physiii/open-dash-daughter/pics/IMG_20180205_184643.jpg

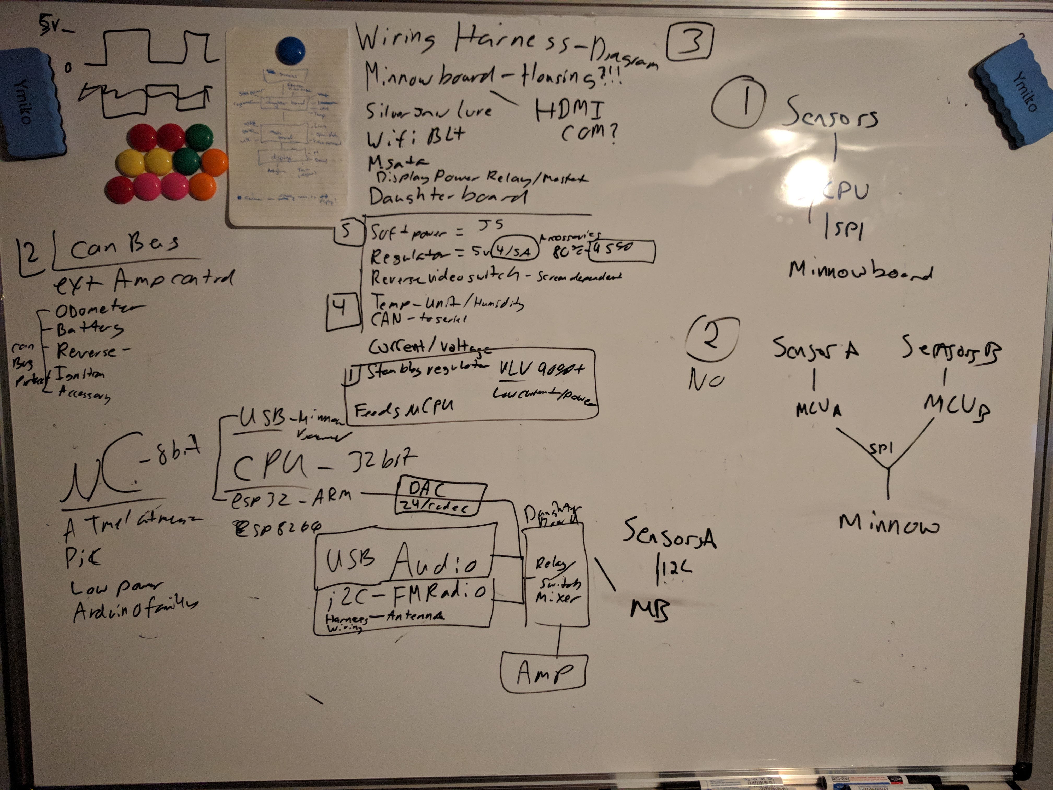
pics/IMG_20180205_184643.jpg
