physiii/open-dash-daughter/documentation/ESP32-MCP2551.jpg

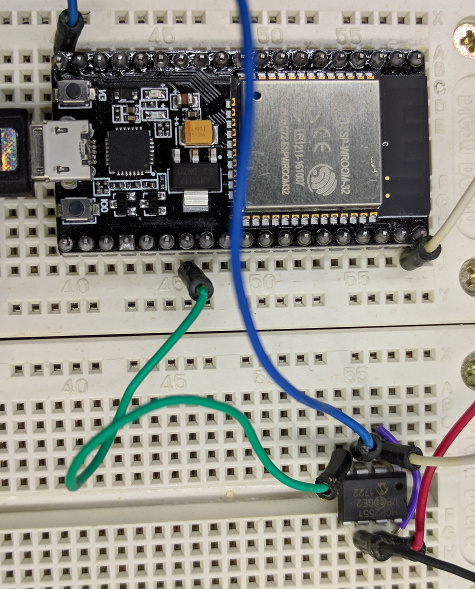
documentation/ESP32-MCP2551.jpg
