physiii/open-dash-daughter/documentation/esp32-dolphin-lights/README.md

let a Dolphin drive the WS2812 LEDs via a serial BT connection to the ESP32

based in part on <https://github.com/FozzTexx/ws2812-demo>
