physiii/open-dash-daughter/documentation/CAN_Static_data.odt

Listing of all IDs that were broadcasting the same data in a ~30 second period without changing, engine was running

Known static conditions:

Outside air temp: 103*F

Odometer: 904 miles

Time/date: 7:01am, Jan 1 2017

Gear: park

ESC mode: on

AC: on

AC fan: on

Speed: 0 mph

6314000: unknown: 0000000000000000

4294001: unknown: 0000B30000000000

421400B: unknown: 00863E0400000000

6214000: Lights, maybe: 0404400000570B00

C054003: unknown: 047005AE815A0000

63D4000: unknown: 9F56000018B70000

4394000: unknown: 00000002

4214006: ESC mode: 0000000000000006

621400A: unknown: 0400

6254000: unknown: 80FFFF00FFFFFF00

6314003: unknown: 0010700000000000

621401A: unknown: 0005010092000000

2214000: unknown: 000000000000

A3D4003: unknown: 2CA51004D0000000

6284000: Steering wheel controls: 0000000000000000

A354003: unknown: 2CA51004D0000000

6314018: Reverse: C000000000000000

62BBF00: unknown: 0000000000000000

A194003: unknown: 0000400000000000

C394003: unknown: C302000008016000

E094000: unknown: 001E05401C4B

E094003: unknown: 001E

E09400A: unknown: 001E

E094018: unknown: 001E

E09401A: unknown: 000E

E094020: unknown: 000A

2294000: unknown: 0000000000000000

C214003: Time/date string: 070101012017

*********************************************************

Another static dump, but with engine off (only one new ID):

4294001: unknown: 0000B30000000000

421400B: unknown: 00863E0400000000

3029100: unknown: 0000000000000000

621401A: unknown: 0005010092000000

4214001: unknown: 0081508B00000000

6214000: Lights, maybe: 0404480000570B00

621400A: unknown: 0400

C054003: unknown: 047005AE895A0000

63D4000: unknown: 9F4F00001AB70000

4394000: unknown: 00000002

4214006: ESC mode: 0000000000000000

6254000: unknown: 00FFFF00FFFFFF00

6314003: unknown: 0010700000000000

2214000: unknown: 000000000000

A3D4003: unknown: 2CA5100500000000

6284000: Steering wheel controls: 0000000000000000

A354003: unknown: 2CA5100500000000

62BBF00: unknown: 0000000000000000

A194003: unknown: 0000400000000000

C394003: unknown: C302000008016000

E094000: Key/ignition status probably: 001E05401C4B

E09400A: unknown: 001E

E094003: unknown: 001E

E094018: unknown: 001E

E09401A: unknown: 000E

E094020: unknown: 000A

6314018: Reverse: C000000000000000

2294000: unknown: 0000000000000000

C214003: Time/date string: 070701012017

***********************************************

IDs that change upon pressing brake:

4294001

421400B

2214000

63D4000

4214001 is more or less static with engine off, but does change as brake pedal is pressed. However, it changes constantly when engine is running. Perhaps this is brake booster pressure.
