physiii/open-dash-daughter/documentation/RadioHarness.pdf

# Connector: Amp PA66−GF35 (PBT−GF15)

# > PBT−GF15 < B1

### RETURN (COMMON)

### CAMERA

### CAMERA SIGNAL

### SHIELD

### CAMERA

CAN
HIGH

LOW

CAN

CHASSIS
GROUND

12vDC
UNSWITCHED

# SPEAKERS

# NEG

# POS

RR− | FR− | FL− | RL−

− MIC +

BL

R REF
IN IN

DET
IN

L
IN

# AUX

3 | 4 | 5

13 18

29

1 | 2 | 6 | 7 | 8 | 9 | 10
11 | 12 | 14 | 15 | 16 | 17 | 19 | 20
21 | 22 | 23 | 24 | 25 | 26 | 27 | 28 | 30
31 | 32 | 33 | 34 | 35 | 36 | 37 | 38 | 39 | 40 | 49 | 50 | 51 | 52
45 | 46 | 47 | 48
41 | 42 | 43 | 44

RADIO ON
(NC)

+
(NC)

NOT CONNECTED ON 2018+ MODELS. LATE MODELS USE CANBUS MESSAGES TO SEND IGNITION/KEY STATUS
