physiii/open-dash-daughter/documentation/CameraHarnessRadio_C.png

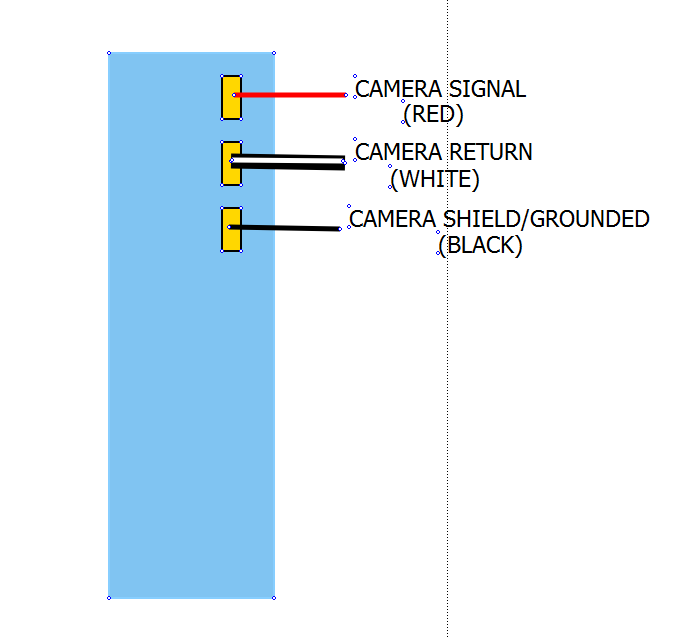
documentation/CameraHarnessRadio_C.png
