physiii/open-dash-daughter/documentation/Stereo wiring.ods

Pin # | Cable Color | Name/Function | Possible function/notes
1 | n/c
2 | Blue/Black | Can +
3 | n/c
4 | n/c
5 | n/c
6 | Green | Aux R | confirmed
7 | Black | Aux Ref
8 | n/c
9 | n/c
10 | n/c
11 | n/c
12 | White/Purple | Can -
13 | Yellow | BL | 12V Battery/Memory
14 | n/c
15 | n/c
16 | White | Aux L | confirmed
17 | Red | Aux DET | 12V Accessory
18 | Black | Ground? | Ground
19 | n/c
20 | n/c
21 | n/c
22 | n/c
23 | n/c
24 | n/c
25 | n/c
26 | n/c
27 | n/c
28 | n/c
29 | Black | Mic -
30 | White | Mic +
31 | Red | Camera Signal
32 | Ground/bare cable | Camera Shield/Ground
33 | Black | Camera Return
34 | n/c
35 | n/c
37 | n/c
37 | n/c
38 | n/c
39 | n/c
40 | n/c
41 | n/c | Radio ON
42 | n/c | 15s +
43 | Black | Ground
44 | Red/Yellow | 30 (+)
45 | Green | Right Rear Speaker (+)
46 | purple/red | Right Front Speaker (+)
47 | Yellow | Left Front Speaker (+)
48 | Orange | Left Rear Speaker (+)
49 | Green/Black | Right Rear Speaker ( - )
50 | Purple/Black | Right Front Speaker ( - )
51 | Yellow/Black | Left Front Speaker ( - )
52 | Orange/Black | Left Rear Speaker ( - )
Blue GPS | 2.188 Kohm
White Radio | open circuit no capacitance
