physiii/open-dash-daughter/open-dash-daughterboard.kicad_pcb

## KiCad design open-dash-daughterboard.kicad_pcb (2018-06-05)

Schematic: power.sch

Parts:
C1, C2, C3, C4: 180uF; CP_Radial_D8.0mm_P3.50mm; Part Number EKZN500ELL181MH20D
C5, C6: 1000uF; CP_Radial_D10.0mm_P5.00mm; Part Number 25YXJ1000M10X20
C7, C8: C_1000uF; CP_Radial_D10.0mm_P3.50mm; Part Number UVR0J102MPD1TD
C9, C12: C_4.7uF; C_0603_1608Metric_Pad0.99x1.00mm_HandSolder; Part Number CL10B475KQ8NQNC
D1: 26V Zener; D_SMB; Part Number SMBJ26CATR
D2, D3, D4, D5: D_Schottky; D_SMA; Part Number CDBA540-HF
D6: LED-0603-G; LED_0603_1608Metric_Pad0.82x1.00mm_HandSolder; Part Number SML-D12M8WT86
L1: L_47uH; Inductor-SRR1210; Part Number SRR1210-470M
L2, L3, L4: L_100uH; Inductor-SRR1210; Part Number SRR1210-101M
R1, R2, R3: R_10k; R_0603_1608Metric_Pad0.99x1.00mm_HandSolder; Part Number RC0603JR-0710KL
R4, R10: R_7k15; R_0603_1608Metric_Pad0.99x1.00mm_HandSolder; Part Number CRCW06037K15FKEA
R5: R_2k32; R_0603_1608Metric_Pad0.99x1.00mm_HandSolder; Part Number RC0603FR-072K32L
R6, R8: R_8k87; R_0603_1608Metric_Pad0.99x1.00mm_HandSolder; Part Number RC0603JR-0710KL
R7, R9: R_1k; R_0603_1608Metric_Pad0.99x1.00mm_HandSolder; Part Number RC0603JR-071KL
R11: R_1k3; R_0603_1608Metric_Pad0.99x1.00mm_HandSolder; Part Number RC0603FR-071K3L
R12: R_1k4; R_0603_1608Metric_Pad0.99x1.00mm_HandSolder; Part Number RC0603FR-071K4L
U1, U2, U3, U4: LM2576-ADJ; Regulator-LM2576; Part Number LM2576SX-ADJ/NOPB
U5: REG-3.3v; TO-252-2; Part Number NCP1117DT33T5G

Connections:
/3v3: C9.1, D6.2, R1.1, R2.1, R3.1, U5.2; also elsewhere on the board
/5V: C5.1, C12.1, L1.2, R4.1, U5.3; also elsewhere on the board
/AUDIO_POWER: C8.1, L2.2, R10.1; also elsewhere on the board
/BATTERY: C1.1, C3.1, C4.1, D1.1, U1.1, U2.1, U4.1; also elsewhere on the board
/DISPLAY_POWER: C7.1, L4.2, R8.1; also elsewhere on the board
/EN_AUDIO: R1.2, U2.5; also elsewhere on the board
/EN_DISPLAY: R3.2, U4.5; also elsewhere on the board
/EN_MAIN: R2.2, U3.5; also elsewhere on the board
/MAIN_POWER: C6.1, L3.2, R6.1; also elsewhere on the board
/V_MAIN: C2.1, U3.1; also elsewhere on the board
AGND: C1.2, C2.2, C3.2, C4.2, C5.2, C6.2, C7.2, C8.2, C9.2, C12.2, D1.2, D2.2, D3.2, D4.2, D5.2, R5.2, R7.2, R9.2, R11.2, R12.2, U1.3, U1.5, U2.3, U3.3, U4.3, U5.1; also elsewhere on the board
unnamed: D2.1, L1.1, U1.2
unnamed: D3.1, L2.1, U2.2
unnamed: D4.1, L3.1, U3.2
unnamed: D5.1, L4.1, U4.2
unnamed: D6.1, R12.1
unnamed: R4.2, R5.1, U1.4
unnamed: R6.2, R7.1, U3.4
unnamed: R8.2, R9.1, U4.4
unnamed: R10.2, R11.1, U2.4

Notes on the sheet:
V_MAIN is after the current sense resistor.
12V Battery Protection
output voltage = 1.23 (1 + R2/R1) R2 is on high side

Schematic: microcontroller.sch

Parts:
C10: C_10uF; C_0603_1608Metric_Pad0.99x1.00mm_HandSolder; Part Number GRM188R61A106ME69D
C11: C_1uF; C_0603_1608Metric_Pad0.99x1.00mm_HandSolder; Part Number CC0603ZRY5V7BB105
R13, R14, R15: R_10k; R_0603_1608Metric_Pad0.99x1.00mm_HandSolder; Part Number RC0603JR-0710KL
U6: ESP-WROOM-32

Connections:
/3v3: C10.1, C11.1, R13.2, R14.2, U6.2; also elsewhere on the board
/CAN_RX: U6.26; also elsewhere on the board
/CAN_TX: U6.29; also elsewhere on the board
/EN_AUDIO: U6.27; also elsewhere on the board
/EN_DISPLAY: U6.23; also elsewhere on the board
/EN_ESP: U6.3; also elsewhere on the board
/EN_MAIN: U6.30; also elsewhere on the board
/FACTORY: U6.13; also elsewhere on the board
/MUTE_AUDIO: U6.9; also elsewhere on the board
/PROG: U6.25; also elsewhere on the board
/RXD: U6.34; also elsewhere on the board
/SCL: R14.1, U6.33; also elsewhere on the board
/SDA: R13.1, U6.31; also elsewhere on the board
/SOFT_POWER: U6.14; also elsewhere on the board
/STBY_AUDIO: U6.8; also elsewhere on the board
/TXD: U6.35; also elsewhere on the board
AGND: C10.2, C11.2, R15.1, U6.1; also elsewhere on the board
unnamed: R15.2, U6.24

Notes on the sheet:
Bypass CAPs

Schematic: canbus.sch

Parts:
C15: 0.1uF; C_0603_1608Metric_Pad0.99x1.00mm_HandSolder; Part Number C0603C104K5RACTU
C16, C17: 560pF; C_0603_1608Metric_Pad0.99x1.00mm_HandSolder; Part Number CL10B561KB8NNNC
D7: PESD1CAN; SOT-323_SC-70_Handsoldering; Part Number PESD1CAN-UX
R18: 4.7k; R_0603_1608Metric_Pad0.99x1.00mm_HandSolder; Part Number RC0603JR-074K7L
R19, R20: 100; R_0603_1608Metric_Pad0.99x1.00mm_HandSolder; Part Number RC0603JR-07100RL
U8: MCP2551-I_SN; SOIC-8_3.9x4.9mm_P1.27mm; Part Number MCP2551-I/SN

Connections:
/5V: C15.1, U8.3; also elsewhere on the board
/CAN+: D7.2, R20.1, U8.7; also elsewhere on the board
/CAN-: D7.1, R19.1, U8.6; also elsewhere on the board
/CAN_RX: U8.4; also elsewhere on the board
/CAN_TX: U8.1; also elsewhere on the board
AGND: C15.2, C16.2, C17.2, D7.3, R18.2, U8.2; also elsewhere on the board
unnamed: C16.1, R19.2
unnamed: C17.1, R20.2
unnamed: R18.1, U8.8

Schematic: environment.sch

Parts:
C18, C19: C_0.1uF; C_0603_1608Metric_Pad0.99x1.00mm_HandSolder; Part Number C0603C104K5RACTU
R21: R_10; R_2512_6332Metric_Pad1.49x3.40mm_HandSolder; Part Number CPF0603B10RE
U9: SI7020-A20; Part Number SI7020-A20-GM1R
U10: Power-Monitor-INA219; SOT-23-8_Handsoldering; Part Number INA219AIDCNR

Connections:
/3v3: C18.1, C19.2, U9.5, U10.4, U10.7; also elsewhere on the board
/BATTERY: R21.1, U10.1; also elsewhere on the board
/SCL: U9.6, U10.5; also elsewhere on the board
/SDA: U9.1, U10.6; also elsewhere on the board
/V_MAIN: R21.2, U10.2; also elsewhere on the board
AGND: C18.2, C19.1, U9.2, U10.3, U10.8; also elsewhere on the board

Schematic: audio-amplifier.sch

Parts:
C20, C21: 0.22uF; C_0603_1608Metric_Pad0.99x1.00mm_HandSolder; Part Number CL10B224KO8NNNC
C22: 470uF; CP_Radial_D8.0mm_P3.50mm; Part Number 16YXJ470M8X11.5
C23, C48, C49: C_1uF; C_0603_1608Metric_Pad0.99x1.00mm_HandSolder; Part Number CC0603ZRY5V7BB105
C24, C44, C45, C51, C52: C_10uF; C_0603_1608Metric_Pad0.99x1.00mm_HandSolder; Part Number GRM188R61A106ME69D
C25: 100nF; C_0603_1608Metric_Pad0.99x1.00mm_HandSolder; Part Number CL10B104KA8NFNC
C47, C53: C_100p; C_0603_1608Metric_Pad0.99x1.00mm_HandSolder; Part Number C0603C101J3GACTU
C50: C_0.1uF; C_0603_1608Metric_Pad0.99x1.00mm_HandSolder; Part Number C0603C104K5RACTU
P1: CONN_01X04; PinHeader_1x04_P2.54mm_Vertical
P2: CONN_01X02; PinHeader_1x02_P2.54mm_Vertical
R22, R23: R_10k; R_0603_1608Metric_Pad0.99x1.00mm_HandSolder; Part Number RC0603JR-0710KL
R43, R44, R45, R46, R47, R48, R49, R50: R_20k; R_0603_1608Metric_Pad0.99x1.00mm_HandSolder; Part Number RC0603JR-0720KL
U11: TDA7297; TO-220-15_Vertical_StaggeredType1_Py5.08mm; Part Number TDA7297
U19: OPA1662; MSOP-8_3x3mm_P0.65mm; Part Number OPA1662AIDGKR

Connections:
/AUDIO_POWER: C22.2, C25.1, C49.1, C50.1, U11.3, U11.13, U19.8; also elsewhere on the board
/FL_AUDIO_OUT+: U11.1; also elsewhere on the board
/FL_AUDIO_OUT-: U11.2; also elsewhere on the board
/FR_AUDIO_OUT+: U11.15; also elsewhere on the board
/FR_AUDIO_OUT-: U11.14; also elsewhere on the board
/L_FM_AUDIO: C44.2, P1.1; also elsewhere on the board
/L_MAIN_AUDIO: C45.2, P1.3; also elsewhere on the board
/MUTE_AUDIO: R22.2; also elsewhere on the board
/R_FM_AUDIO: C51.1, P1.2; also elsewhere on the board
/R_MAIN_AUDIO: C52.1, P1.4; also elsewhere on the board
/STBY_AUDIO: R23.2; also elsewhere on the board
/audio amplifier/L_AUDIO_IN: C47.1, P2.1, R45.1, R50.2, U19.1
/audio amplifier/R_AUDIO_IN: C53.1, P2.2, R48.2, R49.2, U19.7
AGND: C22.1, C23.2, C24.2, C25.2, C48.2, C49.2, C50.2, U11.8, U11.9, U19.4; also elsewhere on the board
unnamed: C20.1, U11.4
unnamed: C20.2, R49.1
unnamed: C21.1, U11.12
unnamed: C21.2, R50.1
unnamed: C23.1, R22.1, U11.6
unnamed: C24.1, R23.1, U11.7
unnamed: C44.1, R43.2
unnamed: C45.1, R44.2
unnamed: C47.2, R43.1, R44.1, R45.2, U19.2
unnamed: C48.1, U19.3, U19.5
unnamed: C51.2, R46.1
unnamed: C52.2, R47.1
unnamed: C53.2, R46.2, R47.2, R48.1, U19.6

Schematic: FM-radio.sch

Parts:
C26: 3.9pF; C_0603_1608Metric_Pad0.99x1.00mm_HandSolder; Part Number CL10C3R9CB8NNNC
C27: 18pF; C_0603_1608Metric_Pad0.99x1.00mm_HandSolder; Part Number VJ0603A180JXACW1BC
C28, C39, C41: 0.1uF; C_0603_1608Metric_Pad0.99x1.00mm_HandSolder; Part Number C0603C104K5RACTU
C29: 270pF; C_0603_1608Metric_Pad0.99x1.00mm_HandSolder; Part Number C0603C271JAGAC7867
C30: 1200pF; C_0603_1608Metric_Pad0.99x1.00mm_HandSolder; Part Number CL10B122KB8NNNC
C31, C33, C34: 0.47uF; C_0603_1608Metric_Pad0.99x1.00mm_HandSolder; Part Number CC0603ZRY5V7BB474
C32: 100uF; C_0603_1608Metric_Pad0.99x1.00mm_HandSolder; Part Number ESK107M010AC3AA
C35: 18nF; C_0603_1608Metric_Pad0.99x1.00mm_HandSolder; Part Number CL10B183JB8NNNC
C36, C40: 22nF; C_0603_1608Metric_Pad0.99x1.00mm_HandSolder; Part Number CL10B223KA8NNWC
C37, C38: 0.39uF; C_0603_1608Metric_Pad0.99x1.00mm_HandSolder; Part Number GRM188R71C394KA88D
D8, D9: D1213A-01SO-7; SOT-23; Part Number D1213A-01SO-7
L5, L6: 6.8uH; Coilcraft_0805PS_Handsoldering; Part number 0805PS-682KLB
L7: 33nH; L_0603_HandSoldering; Part Number CW160808-33NJ
L8: 122nH; L_0603_HandSoldering; Part Number PE-0603CD121GTT
L9: 220uH; Coilcraft_1008PS_Handsoldering; Part Number 1008PS-224KLB
L10: 1mH; L_7.3x7.3_H4.5; Part Number SRR0745A-102M
L11: 33uH; L_6.3x6.3_H3; Part Number SRR0604-330KL
Q1: Q_NPN_BEC; SOT-23; Part Number KST10MTF
Q2, Q3: Q_NJFET_DGS; SOT-23; Part Number BF861C,215
R24: 4.7k; R_0603_1608Metric_Pad0.99x1.00mm_HandSolder; Part Number RC0603JR-074K7L
R25, R27, R28: 249; R_0603_1608Metric_Pad0.99x1.00mm_HandSolder; Part Number RC0603FR-07249RL
R26: 10M; R_0603_1608Metric_Pad0.99x1.00mm_HandSolder; Part Number RC0603JR-0710ML
R29: 10; R_0603_1608Metric_Pad0.99x1.00mm_HandSolder; Part Number RC0603FR-0710RL
R30, R31, R32: 2k; R_0603_1608Metric_Pad0.99x1.00mm_HandSolder; Part Number RC0603JR-072KL
U12: Si4740; QFN-24-1EP_4x4mm_Pitch0.5mm; Part Number TDA7297
U18: 74LVC1G17SE-7; SOT-353_SC-70-5_Handsoldering; Part Number 74LVC1G17SE-7

Connections:
/3v3: C28.2, C36.2, C39.2, C40.2, C41.2, R24.1, R27.1, R29.2, U12.12, U12.13, U18.5; also elsewhere on the board
/AMF_Antenna: C27.2, L5.1; also elsewhere on the board
/FM Radio/FM_INT: U12.20
/FM Radio/FM_RADIO_RST: R30.2
/FM Radio/am_passive_ant_en: R24.2, U12.21, U18.2
/L_FM_AUDIO: C38.1; also elsewhere on the board
/R_FM_AUDIO: C37.1; also elsewhere on the board
/SCL: R31.2; also elsewhere on the board
/SDA: R32.2; also elsewhere on the board
AGND: C26.2, C28.1, C31.1, C32.2, C33.2, C36.1, C39.1, C40.1, C41.1, D8.2, D8.3, D9.2, D9.3, L8.2, L10.2, Q1.2, R26.2, R28.2, U12.2, U12.5, U12.8, U12.14, U18.3; also elsewhere on the board
unnamed: C26.1, L5.2, L6.1
unnamed: C27.1, L7.1
unnamed: C29.1, C30.2, D9.1, Q3.3, R26.1
unnamed: C29.2, L6.2
unnamed: C30.1, Q1.3
unnamed: C31.2, Q2.3
unnamed: C32.1, C33.1, L9.1, R29.1
unnamed: C34.1, L9.2, Q2.1
unnamed: C34.2, U12.6
unnamed: C35.1, L11.2
unnamed: C35.2, L10.1, Q3.2
unnamed: C37.2, U12.15
unnamed: C38.2, U12.16
unnamed: D8.1, L7.2, L8.1, U12.1
unnamed: L11.1, U12.3
unnamed: Q1.1, R25.1
unnamed: Q2.2, Q3.1
unnamed: R25.2, U18.4
unnamed: R27.2, R28.1
unnamed: R30.1, U12.7
unnamed: R31.1, U12.9
unnamed: R32.1, U12.10

Notes on the sheet:
22pF Whip antenna
FM Intrusion FIlter
i2c add: 0010001x
TODO: 32.768kHZ oscillaotr if needed?

Schematic: GPS-interface.sch

Parts:
C42: C_1uF; C_0603; Part Number CC0603ZRY5V7BB105
C43: C_0.1uF; C_0603; Part Number C0603C104K5RACTU
R33, R34, R35, R36, R42: R_10k; R_0603_1608Metric_Pad0.99x1.00mm_HandSolder; Part Number RC0603JR-0710KL
RX_TX1: CONN_01X02; PinHeader_1x02_P2.54mm_Vertical
U13: A2235-H; GSM_Module_17.8x16.5mm_A2235-H; MPN A2235-H; Digi-Key_PN 1530-1011-1-ND

Connections:
/GPS interface/3v3: C42.1, C43.1, R35.1, U13.3 (VCC3V3), U13.11 (VANT)
/GPS interface/ANT_SW: R33.1, U13.12 (ANT_SW)
/GPS interface/EN_I2C: R34.2, U13.8 (GPIO7)
/GPS interface/RST_GPS: R35.2, U13.1 (nRST)
/GPS interface/Vout: R42.1, U13.5 (VOUT)
/GPS interface/WAKEUP: U13.4 (WAKEUP), U13.19 (ON_OFF)
/GPS_Antenna: U13.10 (ANT_EXT); also elsewhere on the board
/SCL: U13.17 (GPIO1); also elsewhere on the board
/SDA: U13.18 (GPIO0); also elsewhere on the board
AGND: C42.2, C43.2, R33.2, R34.1, R36.1, U13.6 (GND), U13.9 (GND), U13.23 (GND); also elsewhere on the board
unnamed: R36.2, U13.20 (EXTINT)
unnamed: R42.2, U13.7 (GPIO6)
unnamed: RX_TX1.1, U13.21 (TXO/SPI)
unnamed: RX_TX1.2, U13.22 (RXO/SPI_DI)

Schematic: interface.sch

Parts:
AMF_Antenna1: Conn_01x02; PinHeader_1x02_P2.54mm_Vertical
AUDIO_IN1: Conn_01x02; PinHeader_1x03_P2.54mm_Vertical
D10, D11, D12: LED; LED_0603_1608Metric_Pad0.82x1.00mm_HandSolder; Part Number 475-2512-2-ND
FACTORY1: SW_PUSH; SW_SPST_KMR2; Part Number KMR211NG LFS
GPS_ANT1: Conn_01x02; PinHeader_1x02_P2.54mm_Vertical
J4: Conn_02x06_Odd_Even; PinHeader_2x06_P2.54mm_Vertical
PROG1: SW_PUSH; SW_SPST_KMR2; Part Number KMR211NG LFS
R16, R17, R38, R39: R_10k; R_0603_1608Metric_Pad0.99x1.00mm_HandSolder; Part Number RC0603JR-0710KL
REBOOT1: SW_PUSH; SW_SPST_KMR2; Part Number KMR211NG LFS
U7, U14, U16: molex-2x4-5.7mm; Part Number 0768290008
U15: radio-housing-mounts

Connections:
/3v3: D10.2 (A), D11.2 (A), D12.2 (A), J4.3, R16.1; also elsewhere on the board
/5V: J4.4, U16.3; also elsewhere on the board
/AMF_Antenna: AMF_Antenna1.1; also elsewhere on the board
/BATTERY: U7.1; also elsewhere on the board
/CAN+: U7.4; also elsewhere on the board
/CAN-: U7.5; also elsewhere on the board
/DISPLAY_POWER: U16.2; also elsewhere on the board
/EN_ESP: R38.2, REBOOT1.1; also elsewhere on the board
/FACTORY: FACTORY1.1, J4.7, R17.2; also elsewhere on the board
/FL_AUDIO_OUT+: U14.1, U14.3; also elsewhere on the board
/FL_AUDIO_OUT-: U14.5, U14.6; also elsewhere on the board
/FR_AUDIO_OUT+: U14.2, U14.4; also elsewhere on the board
/FR_AUDIO_OUT-: U14.7, U14.8; also elsewhere on the board
/GPS_Antenna: GPS_ANT1.1; also elsewhere on the board
/L_MAIN_AUDIO: AUDIO_IN1.2; also elsewhere on the board
/MAIN_POWER: U16.1; also elsewhere on the board
/PROG: J4.5, PROG1.1, R39.2; also elsewhere on the board
/RXD: J4.6; also elsewhere on the board
/R_MAIN_AUDIO: AUDIO_IN1.3; also elsewhere on the board
/SCL: J4.10; also elsewhere on the board
/SDA: J4.9; also elsewhere on the board
/SOFT_POWER: J4.11, R16.2, U7.2, U16.4; also elsewhere on the board
/TXD: J4.8; also elsewhere on the board
/interface/CAMERA+: U7.3
/interface/CAMERA-: U7.6
/interface/CAMERA_S: U7.7
AGND: AMF_Antenna1.2, AUDIO_IN1.1, FACTORY1.2, GPS_ANT1.2, J4.1, J4.2, PROG1.2, REBOOT1.2, U7.8, U16.6, U16.7, U16.8; also elsewhere on the board
unnamed: D10.1 (K), R17.1
unnamed: D11.1 (K), R38.1
unnamed: D12.1 (K), R39.1

Notes on the sheet:
AM/FM Antenna
GPS Antenna

Schematic: usb-interface.sch

Parts:
C13: C_10uF; C_0603; Part Number GRM188R61A106ME69D
C14: C_0.1uF; C_0603; Part Number C0603C104K5RACTU
C46: C_1uF; C_0603; Part Number CC0603ZRY5V7BB105
P4: CONN_01X04; PinHeader_2x04_P2.54mm_Vertical; Part Number 0887388000
Q4: Q_NPN_BCE; SOT-23; Part Number MMSS8050-H-TP
Q5: Q_PNP_BCE; SOT-23; Part Number MMSS8550-L-TP
R37: R_470; R_0603; Part Number RC0603FR-07470RL
R40, R41: R_12k; R_0603_1608Metric_Pad0.99x1.00mm_HandSolder; Part Number RC0603JR-0712KL
U17: USB_IC-CP2104; QFN-24-1EP_3x3mm_Pitch0.4mm; Part Number CP2102N-A01-GQFN20

Connections:
/5V: C13.1, C14.1, P4.1, U17.7, U17.8; also elsewhere on the board
/EN_ESP: Q4.2; also elsewhere on the board
/PROG: Q5.2; also elsewhere on the board
/RXD: R37.1; also elsewhere on the board
/TXD: U17.20; also elsewhere on the board
/USB interface/DCD: P4.2, U17.24
/USB interface/DSR: P4.6, U17.22
/USB interface/DTR: P4.4, Q5.3, R40.2, U17.23
/USB interface/D_N: P4.3, U17.4
/USB interface/D_P: P4.5, U17.3
/USB interface/RTS: P4.8, Q4.3, R41.2, U17.19
AGND: C13.2, C14.2, C46.1, P4.7, U17.2; also elsewhere on the board
unnamed: C46.2, U17.6
unnamed: Q4.1, R40.1
unnamed: Q5.1, R41.1
unnamed: R37.2, U17.21

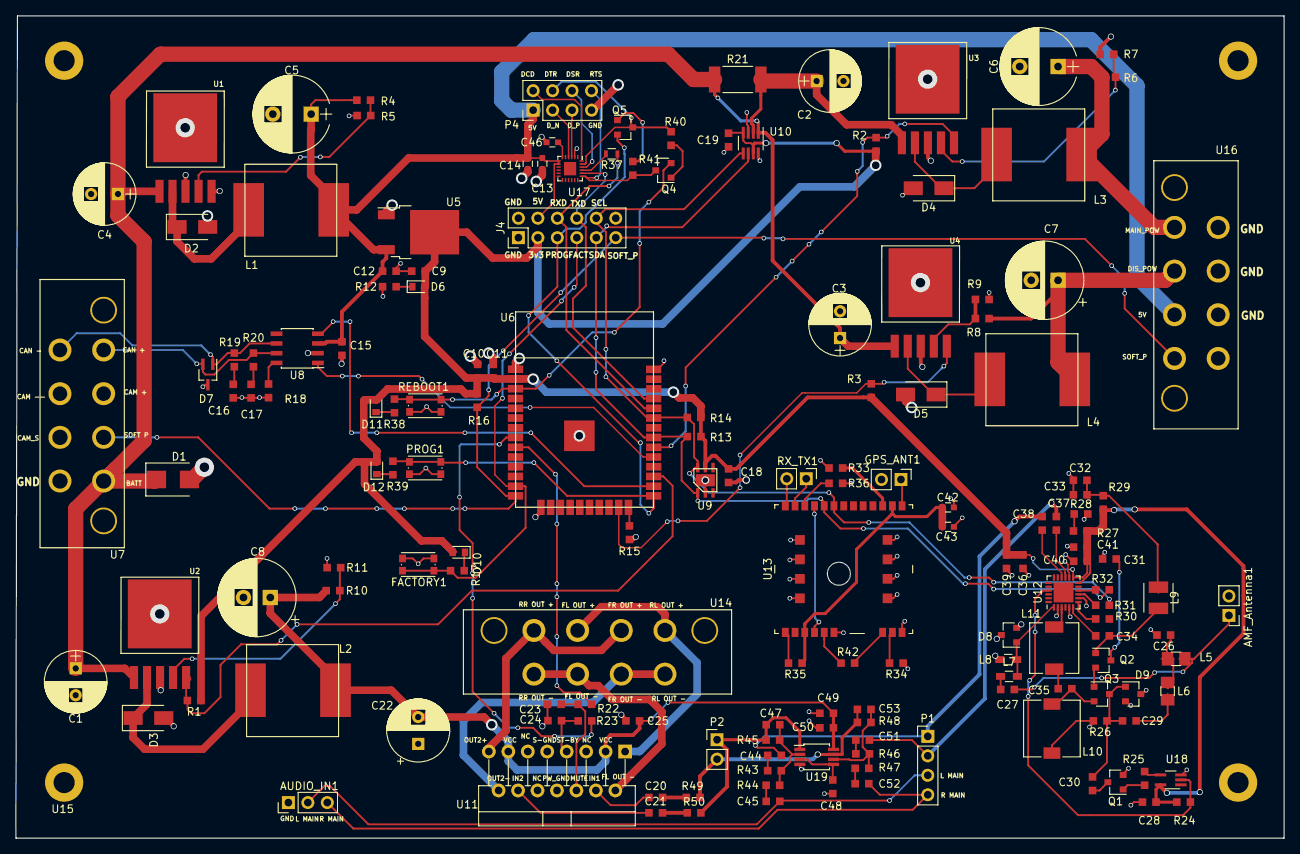
[picture p4: board open-dash-daughterboard.kicad_pcb from above]

Board: 2 copper layers, 165.5 x 107.3 mm, 161 parts (0 on the bottom side), 109 nets.
