physiii/open-dash-daughter/(commit log)

2018-02-08 initial commit, added initial layout and datasheets for esp32 and CM108AH
2018-02-20 added initial layout
    [audio.sch, canbus.sch, open-dash-daughterboard.kicad_pcb, open-dash-daughterboard.sch, processor.sch, sensor.sch, switching regulator.sch]
2018-02-23 merged smart regulator with open-dash-daughter
    [InfraRed.sch, _saved_canbus.sch, audio.sch, canbus.sch, environment.sch, microcontroller.sch, open-dash-daughterboard.sch, power.sch]
2018-03-22 merged in smart regulator
    [_saved_canbus.sch, audio.sch, canbus.sch, environment.sch, microcontroller.sch, open-dash-daughterboard.sch, power.sch, switches.sch]
2018-04-01 rearrange files/dir
    [FM-radio.sch, audio-amplifier.sch, audio-mixer.sch, canbus.sch, composite-input.sch, environment.sch, interface.sch, microcontroller.sch]
2018-04-02 Ethan Initial Commit
    Copy of power section from smart-regulator
    [FM-radio.sch, audio-amplifier.sch, audio-mixer.sch, canbus.sch, composite-input.sch, environment.sch, interface.sch, microcontroller.sch]
2018-04-02 Micro and Environment Schematic Copy
    Copied over the microcontroller and environment sheets from smart-regulator project. Also modified the power section.
    [FM-radio.sch, audio-amplifier.sch, audio-mixer.sch, canbus.sch, composite-input.sch, environment.sch, interface.sch, microcontroller.sch]
2018-04-03 Power Schematic Update
    Test commit and minior power schematic update.
    [FM-radio.sch, audio-amplifier.sch, audio-mixer.sch, canbus.sch, composite-input.sch, environment.sch, interface.sch, microcontroller.sch]
2018-04-03 Backup Before SEPIC Design
    [audio-amplifier.sch, environment.sch, microcontroller.sch, power.sch]
2018-04-04 Component Updates in Power Section
    [power.sch]
2018-04-05 Updated Power Schematic
    Power Schematic Updated for 3.3V, 5V, and 8V Buck Regulators. All regulator parts have correct footprints and selected components.
    Prelim orgainization of PCB - grouped parts by section.
    [environment.sch, microcontroller.sch, open-dash-daughterboard.kicad_pcb, power.sch]
2018-04-05 Update Power Schematic and directed parts to open-automation library
    Change 3.3V and 5V buck regulator to adjustable chip version.
    Directed multiple parts from -cache.lib to open-automation.lib.
    [FM-radio.sch, audio-amplifier.sch, audio-mixer.sch, canbus.sch, composite-input.sch, environment.sch, interface.sch, microcontroller.sch]
2018-04-06 Schematic Work on Audio Amp
    Audio amplifier implemented with selected components and footprints.
    [audio-amplifier.sch, audio-mixer.sch, environment.sch, microcontroller.sch, open-dash-daughterboard.kicad_pcb, power.sch]
2018-04-06 Removed Light Sensor from Enviornment Schematic
    [environment.sch, open-dash-daughterboard.kicad_pcb, power.sch]
2018-04-10 updated to v5 kicad
    [audio.sch, canbus.sch, environment.sch, microcontroller.sch, open-dash-daughterboard.sch, power.sch, switches.sch]
2018-04-12 finished updating libraries
    [audio-amplifier.sch, composite-input.sch, interface.sch, open-dash-daughterboard.sch]
2018-04-12 cleaned up some merge errors
    [open-dash-daughterboard.sch]
2018-04-12 latest and greatest, started canbus schematic
    [FM-radio.sch, audio-amplifier.sch, audio-mixer.sch, canbus.sch, composite-input.sch, environment.sch, interface.sch, microcontroller.sch]
2018-04-17 added thermometer and switches for programming esp8299/esp32
    [bom.ods, switches.sch, thermometer.sch]
2018-04-17 minor mods
    [FM-radio.sch, audio-amplifier.sch, audio-mixer.sch, canbus.sch, composite-input.sch, environment.sch, interface.sch, microcontroller.sch]
2018-04-17 added GPS module, GPS will be on a carrier board and will plug into the daughter board.
    [bom.ods]
2018-04-17 Backup before switching to lawrence-test branch
    Schematic library has issues after updating to KiCad V5.
    [FM-radio-2018-04-17-11-42-57.sch, FM-radio-2018-04-17-12-17-10.sch, FM-radio-2018-04-17-12-17-32.sch, FM-radio-2018-04-17-12-18-42.sch, FM-radio-2018-04-17-12-21-20.sch, audio-amplifier-2018-04-17-11-42-57.sch, audio-amplifier-2018-04-17-12-17-10.sch, audio-amplifier-2018-04-17-12-17-32.sch]
2018-04-18 Revert "Backup before switching to lawrence-test branch"
    This reverts commit 5eeefb6d84a8db9381deb81c77fe1ec3b29fea69.
    [FM-radio-2018-04-17-11-42-57.sch, FM-radio-2018-04-17-12-17-10.sch, FM-radio-2018-04-17-12-17-32.sch, FM-radio-2018-04-17-12-18-42.sch, FM-radio-2018-04-17-12-21-20.sch, FM-radio.sch, audio-amplifier-2018-04-17-11-42-57.sch, audio-amplifier-2018-04-17-12-17-10.sch]
2018-04-18 Revert "Merge branch 'lawrence_test' into ethan"
    This reverts commit 4dccd689ac590a7d6c1598150e10b9b87c6b396b, reversing
    changes made to 5eeefb6d84a8db9381deb81c77fe1ec3b29fea69.
    [FM-radio.sch, InfraRed.sch, audio-amplifier.sch, audio-mixer.sch, bom.ods, canbus.sch, composite-input.sch, environment.sch]
2018-04-18 Revert "Revert "Merge branch 'lawrence_test' into ethan""
    This reverts commit 6eb6401587b4cfce8c2da15c6df37be90675c3d0.
    [power.sch]
2018-04-18 Revert "added GPS module, GPS will be on a carrier board and will plug into the daughter board."
    This reverts commit f32f9f36995d7517ca6e5476fe45c3fadeca4b65.
    [bom.ods]
2018-04-18 Revert "minor mods"
    This reverts commit 9cdac2227bb00ba5c1e83bbc5802a50bbe9e1756.
    [FM-radio-2018-04-17-22-16-54.sch, FM-radio-2018-04-17-22-17-17.sch, FM-radio-2018-04-17-22-20-05.sch, audio-amplifier-2018-04-17-22-16-54.sch, audio-amplifier-2018-04-17-22-17-17.sch, audio-amplifier-2018-04-17-22-20-05.sch, audio-mixer-2018-04-17-22-16-54.sch, audio-mixer-2018-04-17-22-17-17.sch]
2018-04-18 Fixed Ethan Branch to actually merge "lawrence_test" branch
    Had some clinfict issues that were handeled incorrectly. Problems now fixed.
    [FM-radio-2018-04-17-22-01-15.sch, FM-radio-2018-04-17-22-03-20.sch, FM-radio-2018-04-17-22-03-44.sch, FM-radio-2018-04-17-22-16-54.sch, FM-radio-2018-04-17-22-17-17.sch, FM-radio-2018-04-17-22-20-05.sch, FM-radio.sch, InfraRed.sch]
2018-04-18 Implemented CANBUS circuitry
    Implemented CANBUS circuitry based off sparkfun CAN-BUS Shield DEV-1326. Footprints and parts selected.
    [audio-amplifier.sch, canbus.sch, open-dash-daughterboard.sch]
2018-04-19 merged ethans changes
    [audio-amplifier.sch, canbus.sch, open-dash-daughterboard.sch]
2018-04-19 added connector in bom
    [bom.ods]
2018-04-19 started AM/FM module, added datasheets
    [FM-radio.sch, audio-amplifier.sch, bom.ods, canbus.sch, composite-input.sch, interface.sch, microcontroller.sch, switches.sch]
2018-04-19 FM Radio schematic in process
    [FM-radio.sch, open-dash-daughterboard.sch]
2018-04-19 implemented rough draft of FM circuit
    [FM-radio.sch, canbus.sch, open-dash-daughterboard.sch, power.sch, switches.sch]
2018-04-19 added GPS sheet and part, first draft needs further review
    [FM-radio.sch, GPS interface.sch, audio-amplifier.sch, audio-mixer.sch, canbus.sch, composite-input.sch, environment.sch, interface.sch]
2018-04-20 added canbus info
    [CANBUS_Messages.ods]
2018-04-23 update ground symbols
    [canbus.sch, open-dash-daughterboard.sch]
2018-04-26 dangling commit
    [FM-radio.sch, GPS interface.sch]
2018-04-26 added pinout for wireharness and canbus library
2018-04-26 updated BOM with RF AM/FM connectors and added connector pinout descriptions in Stereo wiring.ods
    [Stereo wiring.ods, bom.ods]
2018-04-26 updated wiring list
    [Stereo wiring.ods]
2018-04-26 added connector interface
    [interface.sch, open-dash-daughterboard.sch]
2018-04-26 adding and cleaning lables
    [GPS interface.sch, environment.sch, open-dash-daughterboard.sch]
2018-04-27 add MCP2551 datasheet and ESP32-MCP2551 wiring table and picture
    [ESP32-MCP2551 Wiring.ods]
2018-04-27 demo esp32 canbus capture based on http://www.barth-dev.de/can-driver-esp32/
2018-04-27 FM/AM Radio Section Schematic Work and Parts Selection
    [FM-radio.sch, open-dash-daughterboard.sch, power.sch]
2018-04-27 Added usb-audio interface schematic
    [FM-radio.sch, GPS interface.sch, audio-amplifier.sch, audio-interface.sch, audio-mixer.sch, canbus.sch, composite-input.sch, environment.sch]
2018-05-01 dummy ids for key on/off events with 30-second shutdown timer
2018-05-01 Slight re-arrangment, and added datasheets for potential video options.
    [GPS interface.sch, canbus.sch, interface.sch, open-dash-daughterboard.sch]
2018-05-02 can-capture program to print frames with sequence # and ticks; scripts+captures for ignition and lock-unlock-door
2018-05-02 separate vehicle power monitor project from can capture project (still untested and with dummy key on/off CAN IDs)
2018-05-05 initial commit of unmodified ws2812-demo code, basis for Dolphin LED modifications
2018-05-06 (untested) ESP32 program to receive JSON LED state change description from BT SPP client and set light status (WS2812 code didn't work)
    [main.c]
2018-05-06 attempt to manually feed WS2812 timings to RMT driver
2018-05-07 Static CAN messages
    Just a dump of all CAN message labels being broadcast whose contents do not change. First dump is with engine on, second with engine off. Only one additional message label appears to stop changing with engine off, suspect data like RPM, fuel flow, etc are part of messages that contain other data that changes more frequently (such as engine temps).
2018-05-11 added mainboard-interface
    [CANBUS_Messages.ods, ESP32-MCP2551 Wiring.ods, FM-radio.sch, GPS interface.sch, InfraRed.sch, Stereo wiring.ods, audio-amplifier.sch, audio-interface.sch]
2018-05-11 organized bus connections
    [open-dash-daughterboard.sch]
2018-05-11 Updated with numerous new CAN messages 5-12-18
    [CANBUS_Messages.ods]
2018-05-15 print messages as strings
2018-05-22 New data 5-22-18 for side & back doors, one correction
    I've discovered there is apparently no data tied to key insertion state, and I've corrected that documentation in the spreadsheet. - Matt
    [CANBUS_Messages.ods]
2018-05-27 made kicad-parts path relative
2018-06-02 start building daughter state machine for can-triggered dash power on/off
2018-06-02 switch back to real non-debug build
2018-06-03 wait after power up/down status; dashsim.js to simulate the dash for debug purposes (use instead of make monitor)
2018-06-04 Working on it
    [open-dash-daughterboard.kicad_pcb]
2018-06-04 Corrected spacing on dashsim.js and some constants and variables
    [dashsim.js]
2018-06-05 rearranged traces
    [open-dash-daughterboard.kicad_pcb]
2018-06-05 molex fix
    [open-dash-daughterboard.sch]
2018-06-05 added BOM
    [open-dash-daughterboard.csv]
2018-06-05 final update silk screen
    [open-dash-daughterboard.kicad_pcb]
2019-04-21 starting next revision
    [FM-radio.sch, GPS-interface.sch, audio-amplifier.sch, audio-mixer.sch, canbus.sch, environment.sch, interface.sch, microcontroller.sch]
